nguyentrongtri-05/balance-robot/luu_do_dieu_khien_fuzzy.pdf

## LƯU ĐỒ ĐIỀU KHIỂN & TỔNG HỢP CÁC GIẢI THUẬT — BỘ LỌC XỬ LÝ TÍN HIỆU

Hệ thống Robot Hai Bánh Tự Cân Bằng trên Vi điều khiển STM32F407VG (FreeRTOS 200 Hz — Cascaded Dual-FuzzyPD & Kalman Sensor Fusion)

1. Lưu đồ Kiến trúc Hệ thống Điều khiển Vòng lồng & Đa nhiệm Thời gian thực (FreeRTOS 200 Hz)

Toàn bộ thuật toán ước lượng trạng thái, lọc nhiễu và điều khiển của robot được vận hành đồng bộ ở tần số 200 Hz (chu kỳ lấy mẫu dt = 0.005 s) trên hệ điều hành thời gian thực FreeRTOS. Công suất điều khiển tổng của cầu H ( MOTOR_PWM_PERIOD = 8400 tại tần số 10.0 kHz ) được phân bổ chặt chẽ: 90% công suất ( ±7560 PWM ) dành cho bộ điều khiển cân bằng dọc (Pitch) và 10% công suất ( ±840 PWM ) dành cho bộ điều khiển giữ hướng xoay ngang (Yaw).

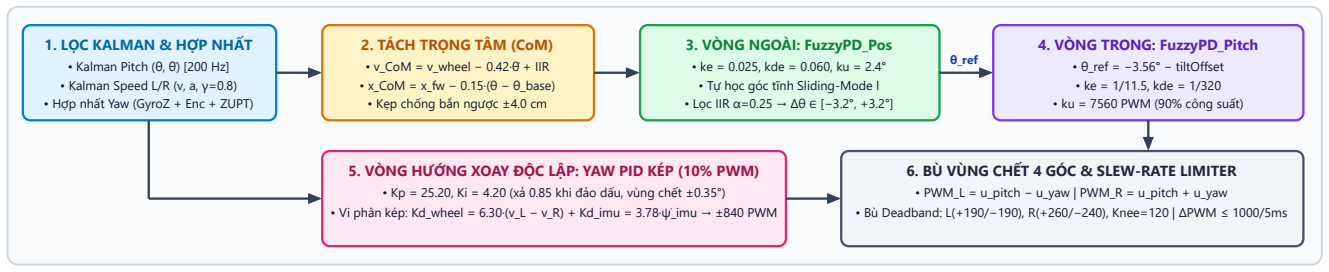
[picture p1: figure]
1. LỌC KALMAN & HỢP NHẤT • Kalman Pitch (θ, θ̇) [200 Hz] • Kalman Speed L/R (v, a, γ=0.8) • Hợp nhất Yaw (GyroZ + Enc + ZUPT); 2. TÁCH TRỌNG TÂM (CoM) • v_CoM = v_wheel − 0.42·θ̇ + IIR • x_CoM = x_fw − 0.15·(θ − θ_base) • Kẹp chống bắn ngược ±4.0 cm; 3. VÒNG NGOÀI: FuzzyPD_Pos • ke = 0.025, kde = 0.060, ku = 2.4° • Tự học góc tĩnh Sliding-Mode I • Lọc IIR α=0.25 → Δθ ∈ [−3.2°, +3.2°]; θ_ref; 4. VÒNG TRONG: FuzzyPD_Pitch • θ_ref = −3.56° − tiltOffset • ke = 1/11.5, kde = 1/320 • ku = 7560 PWM (90% công suất)

### 5. VÒNG HƯỚNG XOAY ĐỘC LẬP: YAW PID KÉP (10% PWM)

- Kp = 25.20, Ki = 4.20 (xả 0.85 khi đảo dấu, vùng chết ±0.35°)
- Vi phân kép: Kd_wheel = 6.30·(v_L − v_R) + Kd_imu = 3.78·ψ̇_imu → ±840 PWM

### 6. BÙ VÙNG CHẾT 4 GÓC & SLEW-RATE LIMITER

- PWM_L = u_pitch − u_yaw | PWM_R = u_pitch + u_yaw
- Bù Deadband: L(+190/−190), R(+260/−240), Knee=120 | ΔPWM ≤ 1000/5ms
Tên Task | Chu kỳ / Tần số | Ưu tiên | Stack (Words) | Nhiệm vụ & Giải thuật Thực thi Chính ( MY_LIB/managetask.c )
vTaskControl | 5 ms (200 Hz) | 4 (Cao nhất) | 1024 | Tách vận tốc/vị trí CoM, thực thi vòng ngoài FuzzyPD_Pos , tự học góc cân bằng tĩnh, vòng trong FuzzyPD_Pitch , bộ điều khiển Yaw PID , bù vùng chết động cơ và giới hạn Slew-Rate.
vTaskIMU | 5 ms (200 Hz) | 3 | 512 | Đọc 6 trục MPU6050 qua I2C1, tính góc g_rawAccPitch , tự hiệu chuẩn điểm 0 Gyro Z (ZUPT), hợp nhất vận tốc góc Yaw (Gyro Z + Encoder) và chạy 2 bộ lọc kalmanPitch , kalmanYaw .
vTaskEncoder | 5 ms (200 Hz) | 3 | 512 | Đọc xung vuông pha 4x từ TIM3 / TIM4 , lọc cắt gai phần cứng, tính vận tốc thô 2 bánh, chạy 2 bộ lọc kalmanSpeed_L / R và tích lũy quãng đường/góc xoay Odometry.
vTaskUART | 10 ms (100 Hz) | 2 | 512 | Giải mã gói lệnh điều khiển từ App GUI (Start/Stop/Calib/Joystick/Tuning) kiểm tra XOR Checksum và truyền khung Telemetry DMA ( 0xAA ... 0xFF ) ở tần số 50 Hz.

## 2. Xử lý Cảm biến Thô & Các Bộ lọc Tiền xử lý Phần cứng

2.1. Cảm biến Quán tính MPU6050 ( driver_i2c.c ,
managetask.c )
Bộ lọc thông thấp số nội (Hardware DLPF): Thanh ghi
CONFIG (0x1A) = 0x03 kích hoạt bộ lọc thông thấp phần cứng băng thông 44 Hz cho gia tốc kế và 42 Hz cho con quay hồi chuyển, triệt tiêu rung động cơ khí tần số cao từ động cơ trước khi lấy mẫu.
Thang đo (Full-Scale Range): Gia tốc kế ±2g ( 16384
LSB/g ), Gyroscope ±500 °/s ( 65.5 LSB/(°/s) ).
Tính góc nghiêng Pitch 3 trục & Bảo vệ dấu azSign :

θacc = atan2(−ax

, √(ay

2 + az

2
)) · (180 / π) | (1)

θ̇gyro = sign(az

) · (gy,raw − gy,offset

) / 65.5 | (2)

### 2.2. Encoder Vuông pha 4x & Lọc Cắt Gai ( encoder.c )

Bộ lọc số đầu vào Timer (Digital Input Capture Filter): Cấu hình TIM_EncoderMode_TI12 (đếm 4 cạnh xung A/B,
330 × 4 = 1320 xung/vòng ) kèm bộ lọc số phần cứng
IC1F = IC2F = 0x0F trên thanh ghi CCMR1 để loại bỏ nhiễu xuyên âm từ dây động cơ.
Khử tràn 16-bit & Bộ lọc Cắt Gai (Spike Rejection Filter): Với vận tốc tối đa của xe, số xung trong 5 ms luôn nhỏ hơn 45 xung. Nếu xuất hiện gai nhiễu bất thường | ΔN| > 45 xung/5ms , thuật toán giữ nguyên mẫu hợp lệ
liền trước:

Nếu |ΔNk

| > 45 ⇒ ΔNk = ΔNk−1 | (3)

vraw (RPM) = (60 · ΔNk

) / (1320 · 0.005) = 9.0909 · ΔNk

(4)

## 3. Các Bộ lọc Kalman Không gian Trạng thái (State-Space Kalman Filters)

Hệ thống sử dụng 4 bộ lọc Kalman tuyến tính 2 trạng thái chạy độc lập ở tần số 200 Hz ( MY_LIB/kalman.c ): 2 bộ lọc cho góc tư
thế ( kalmanPitch , kalmanYaw ) và 2 bộ lọc động học cho vận tốc bánh xe ( kalmanSpeed_L , kalmanSpeed_R ).

### 3.1. Bộ lọc Kalman Góc nghiêng & Độ trôi Gyro ( Kalman_t : kalmanPitch , kalmanYaw )

Gia tốc kế cho góc tuyệt đối không trôi nhưng chịu nhiễu gia tốc tịnh tiến rất lớn khi xe tăng/giảm tốc; ngược lại Gyroscope phản

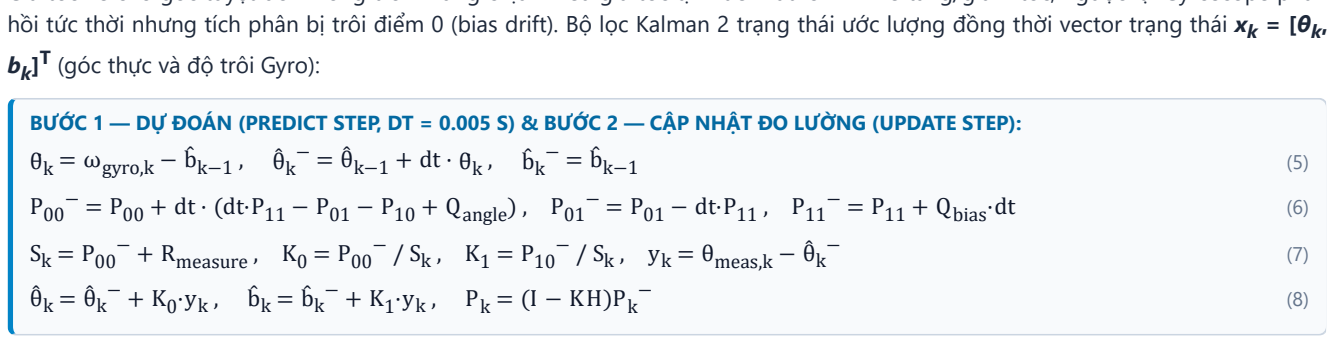
[picture p2: figure]
(góc thực và độ trôi Gyro):; θ̇k = ωgyro,k − b̂k−1; − = P11 + Qbias·dt; − + Rmeasure; , yk = θmeas,k − θ̂k

hồi tức thời nhưng tích phân bị trôi điểm 0 (bias drift). Bộ lọc Kalman 2 trạng thái ước lượng đồng thời vector trạng thái xk = [θk

BƯỚC 1 — DỰ ĐOÁN (PREDICT STEP, DT = 0.005 S) & BƯỚC 2 — CẬP NHẬT ĐO LƯỜNG (UPDATE STEP):

− = P00 + dt · (dt·P11 − P01 − P10 + Qangle

### 3.2. Bộ lọc Kalman Động học Vận tốc Bánh xe có Tắt dần Gia tốc ( KalmanSpeed_t )

Ở tần số lấy mẫu 200 Hz ( dt = 5 ms ), độ phân giải rời rạc của 1 xung Encoder tương ứng với bước nhảy bậc thang 9.09 RPM ( ≈ 3.09 cm/s ). Nếu dùng bộ lọc thông thấp RC thông thường để làm mượt bậc thang này sẽ gây trễ pha lớn ( > 50 ms ) làm xe dao động. Bộ lọc KalmanSpeed_t mô hình hóa vector trạng thái xk = [vk

, ak

]

T
(vận tốc RPM và gia tốc góc RPM/s) kết hợp hệ số tắt dần gia tốc γ = 0.80 giúp triệt tiêu hiện tượng vọt lố (overshoot) khi bánh xe đổi chiều đột ngột:

DỰ ĐOÁN ĐỘNG HỌC CÓ TẮT DẦN GIA TỐC (Γ = 0.80) & CẬP NHẬT VẬN TỐC ENCODER:

âk

− = 0.80 · âk−1
, | v̂k

− = v̂k−1 + âk

− · dt | (9)

P00

− = P00 + dt·(2P01 + dt·P11
) + Qspeed

, P01

− = P01 + dt·P11
, P11

− = P11 + Qaccel
·dt | (10)

K0 = P00

− / (P00

− + Rmeasure
) , K1 = P01

− / (P00

− + Rmeasure
) , v̂k = v̂k

− + K0
(vraw,k − v̂k

−) , âk = âk

− + K1
(vraw,k

− v̂k

−)

(11)

Bộ lọc Kalman | Biến trạng thái ước lượng | Nhiễu quá trình Q1 | Nhiễu quá trình Q2 | Nhiễu đo lường R | Đặc tính Đáp ứng Tần số / Ý nghĩa Vật lý
kalmanPitch , kalmanYaw | [angle (°), bias (°/s)] | Q_angle = 0.001 | Q_bias = 0.003 | R_measure = 0.03 | Khử hoàn toàn nhiễu rung gia tốc kế, tự động bám độ trôi nhiệt Gyro, không gây trễ pha vận tốc góc rate .
kalmanSpeed_L , kalmanSpeed_R | [speed (RPM), accel (RPM/s)] | Q_speed = 0.40 | Q_accel = 50.0 | R_measure = 5.0 | Làm phẳng hoàn toàn bậc thang lượng tử hóa 9.09 RPM/xung với độ trễ pha cực thấp ( < 20 ms ).

## 4. Giải thuật Hợp nhất Cảm biến Hướng xoay Yaw (Rate-Domain Fusion & ZUPT)

Khác với góc Pitch có trọng lực làm tham chiếu tuyệt đối, góc hướng xoay ngang Yaw (ψ) không có từ kế nên dễ bị trôi theo thời gian nếu chỉ tích phân Gyro Z, hoặc bị sai lệch nếu bánh xe bị trượt khi chỉ dùng Encoder. Đặc biệt, nếu trộn trực tiếp góc Encoder vào góc Gyro sẽ gây lỗi vật lý: khi thân xe bị xoay bởi ngoại lực rồi dừng lại ở hướng mới, hai bánh xe đứng yên làm góc Encoder cố định và kéo ngược góc Yaw về vị trí cũ. Để giải quyết triệt để, hệ thống thực hiện Hợp nhất trên miền Vận tốc góc (Rate-Domain Sensor Fusion) kết hợp Cập nhật Vận tốc Góc Bằng Không (ZUPT — Zero Angular Velocity Update) trong vTaskIMU :

### 4.1. TỰ ĐỘNG BÙ TRÔI ĐIỂM 0 TĨNH CỦA GYRO Z (ONLINE ZUPT BIAS CALIBRATION):

Nếu |ψ̇enc

| < 1.0 °/s và |gz,raw − gz,offset

| < 80 LSB ⇒ gz,offset

[k] = 0.995 · gz,offset

| [k−1] + 0.005 · gz,raw[k] | (12)

### 4.2. LUẬT HỢP NHẤT VẬN TỐC GÓC YAW BA CHẾ ĐỘ (3-REGIME RATE FUSION):

ψ̇enc = ((−v̂L − (−v̂R

)) · 0.34034) · (180 / (π · 19.21)) [°/s] | (13)
ψ̇fused = 0.0 °/s (khi |ψ̇gyro

| < 0.7 °/s và |ψ̇enc

| < 1.2 °/s — Khóa tĩnh ZUPT chống trôi tuyệt đối) = 0.80 · ψ̇gyro + 0.20 · ψ̇enc

(khi |ψ̇enc

| ≥ 1.0 °/s, ψ̇gyro

| ·ψ̇enc > 0 và |ψ̇gyro − ψ̇enc | < 20 °/s — Lăn đồng bộ)
= 1.00 · ψ̇gyro

(các trường hợp còn lại — Tác động ngoại lực xoay thân xe / trượt bánh / nhấc bổng)

(14)

ψraw[k] = ψraw[k−1] + ψ̇fused

- 0.005 , ψfiltered

[k] = Kalman_GetAngle (& kalmanYaw , ψraw[k], ψ̇gyro

, 0.005) | (15)

## 5. Khử Nhiễu Giao thoa Trọng tâm (CoM Decoupling) & Các Bộ lọc Vòng Ngoài

Đối với con lắc ngược hai bánh, khi thân xe nghiêng nhanh với vận tốc góc θ̇ để tự cân bằng, hai bánh xe phải quay cùng chiều nghiêng. Nếu đưa trực tiếp vận tốc và vị trí bánh xe vào vòng ngoài, bộ điều khiển vị trí sẽ hiểu nhầm xe đang trôi đi và ra lệnh nghiêng ngược lại, gây dao động cộng hưởng (Non-Minimum Phase coupling). Hệ thống giải quyết bằng chuỗi 5 bộ lọc tách chuyển động Trọng tâm (Center-of-Mass — CoM):

5.1. TÁCH VẬN TỐC TỊNH TIẾN TRỌNG TÂM (COM VELOCITY DECOUPLING) & LỌC THÔNG THẤP IIR BẬC 1:
vCoM,raw = vwheel − kω · clamp(θ̇kalman, −60 °/s, +60 °/s) , | với kω = 0.42 RPM/(°/s) | (16)
v̂CoM[k] = v̂CoM[k−1] + αv
- (vCoM,raw[k] − v̂CoM[k−1]) , | với αv = 0.22 (tần số cắt fc ≈ 8.0 Hz) | (17)

### 5.2. TÁCH VỊ TRÍ TRỌNG TÂM (COM POSITION DECOUPLING):

xfw = 0.5 · (NL + NR − Nref

) · 0.01547 cm , | xCoM = xfw − kθ
| · (θfiltered − θbase
| ) với kθ = 0.15 cm/° | (18)

### 5.3. BỘ KẸP CHỐNG BẮN NGƯỢC VỊ TRÍ (ANTI-SLINGSHOT POSITION CLAMPING & BRAKE-IN-PLACE):

Khi đang lái (|vcmd

| > 0.1 RPM): xtarget ← clamp(xtarget + vcmd,cms

| ·dt, xfw − 12.0 cm , xfw + 12.0 cm ) | (19)
Khi vừa nhả tay lái: chốt tức thời xtarget = xCoM (phanh đứng tại chỗ, không giật lùi về gốc cũ) | (20)

Khi đứng yên bị đẩy: xtarget ← clamp(xtarget

, xfw − 4.0 cm , xfw + 4.0 cm ) ( POS_HOLD_MAX_ERR_CM = 4.0 ) | (21)
5.4. TỰ ĐỘNG HỌC GÓC CÂN BẰNG TĨNH THEO MẶT TRƯỢT (SLIDING-MODE STATIC BALANCE AUTO-TRIM):
Mặt trượt: spos = epos + 1.2 · vCoM,cms

(trong đó epos = xfw − xtarget

| ) | (22)
Nếu epos
- spos > 0: θI,pos

[k] = clamp(θI,pos

[k−1] − 0.004 · clamp(spos

| , −4, +4) · dt, − 1.20° , + 1.20° ) | (23)

### 5.5. LỌC THÔNG THẤP GÓC NGHIÊNG ĐẶT VÒNG NGOÀI (OUTER-LOOP TILT COMMAND IIR FILTER):

Δθfilt

[k] = Δθfilt

[k−1] + 0.25 · (Δθfuzzy

[k] − Δθfilt

[k−1]) , Δθtotal = clamp(θI,pos + Δθfilt

| , − 3.2° , + 3.2° ) | (24)

Ý nghĩa Vật lý của Bộ kẹp Chống Bắn Ngược (Phương trình 21): Khi người dùng tác động lực đẩy mạnh làm xe lăn đi 15–30 cm để lấy lại thăng bằng, nếu giữ nguyên xtarget = 0 thì sai số vị trí epos tích lũy rất lớn sẽ ép vòng ngoài nghiêng xe mạnh về phía sau (hiệu ứng dây ná slingshot) ngay lúc xe vừa phanh lại, làm xe ngã ngửa. Kẹp POS_HOLD_MAX_ERR_CM = 4.0 cm cho phép điểm đích trượt theo chân xe khi bị đẩy xa, giúp vòng ngoài tập trung hãm vận tốc vCoM về 0 tại vị trí mới rồi nhẹ nhàng giữ xe đứng vững trong phạm vi ±4 cm.

## 6. Giải thuật Điều khiển Mờ Kép Nối tiếp (Cascaded Dual-FuzzyPD)

Cả hai bộ điều khiển vòng ngoài ( FuzzyPD_Pos ) và vòng trong ( FuzzyPD_Pitch ) đều dùng chung kiến trúc hàm FuzzyPD_Compute() trong MY_LIB/fuzzy.c gồm 5 khâu xử lý chuẩn hóa trên miền [-1.0, +1.0]:

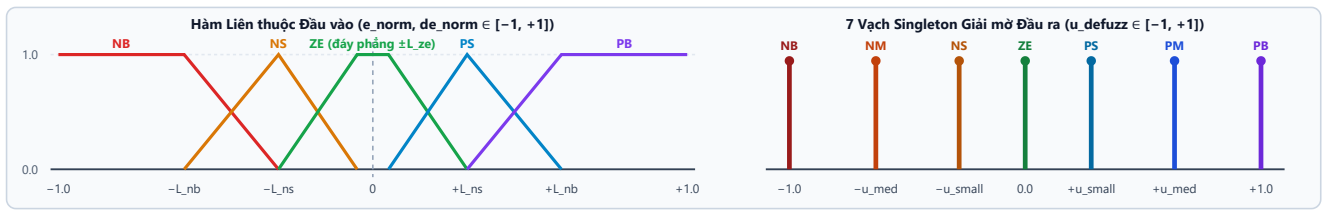
[picture p3: figure]
ZE (đáy phẳng ±L_ze); −u_med; −u_small; +u_small; +u_med

Hàm Liên thuộc Đầu vào (e_norm, de_norm ∈ [−1, +1])

### 7 Vạch Singleton Giải mờ Đầu ra (u_defuzz ∈ [−1, +1])

CHUẨN HÓA ĐẦU VÀO, SUY DIỄN TÍCH ĐẠI SỐ LARSEN (25 LUẬT) & GIẢI MỜ TRUNG BÌNH TRỌNG SỐ 7 SINGLETON:

### 6.1. Ma trận Luật Mờ Đối xứng Chuẩn 5×5 (25 Luật)

e \ de | NB | NS | ZE | PS | PB
NB | NB | NB | NM | NS | ZE
NS | NB | NM | NS | ZE | PS
ZE | NM | NS | ZE | PS | PM
PS | NS | ZE | PS | PM | PB
PB | ZE | PS | PM | PB | PB

### 6.2. Thông số Tinh chỉnh Thực tế ( MDK_ARM/main.c )

Tham số Cấu
hình

FuzzyPD_Pitch
(Vòng Trong)

FuzzyPD_Pos
(Vòng Ngoài)
Hệ số chuẩn hóa ke | 1 / 11.5 ≈ 0.08696 (±11.5°) | 0.025 (±40.0 cm)
Hệ số chuẩn hóa kde | 1 / 320 = 0.003125 (±320 °/s) | 0.060 (±16.7 cm/s)

Khuếch đại ngõ
ra ku

7560.0 PWM (90%
Full)

2.40° (Góc
nghiêng đặt)
Mốc mờ hóa e (NB, NS, ZE) | (0.46, 0.20, 0.002) | (0.44, 0.16, 0.002)
Mốc mờ hóa de (NB, NS, ZE) | (0.46, 0.20, 0.005) | (0.46, 0.18, 0.010)
Singleton (u_small, u_med) | (0.25, 0.65) | (0.26, 0.62)
Độ lợi tuyến tính tương đương | Kp ≈ 822 PWM/°, Kd ≈ 29.5 PWM/(°/s) | Kp ≈ 0.098 °/cm, Kd ≈ 0.208 °/(cm/s)

## 7. Điều khiển Hướng xoay Yaw PID Kép & Xử lý Công suất Động cơ

7.1. BỘ ĐIỀU KHIỂN YAW PID KÉP VI PHÂN (DUAL-DERIVATIVE YAW PID — 10% CÔNG SUẤT = ±840 PWM):

uyaw = clamp( Kp,yaw·eyaw + Ki,yaw·Iyaw + Kd,wheel

·(−v̂L + v̂R

) + Kd,imu

·ψ̇kalman , −840, +840 ) | (26)
- Thông số: Kp_yaw = 25.20 , Ki_yaw = 4.20 , Kd_wheel = 6.30 , Kd_imu = 3.78 . Chống bão hòa tích phân (Anti-Windup): vùng chết tích phân |e_yaw| > 0.35° , kẹp ±25.0 , và xả nhanh I_yaw *= 0.85 mỗi chu kỳ khi e_yaw đảo dấu để triệt tiêu vọt lố hướng xoay.
7.2. BÙ VÙNG CHẾT BẤT ĐỐI XỨNG 4 GÓC PHẦN TƯ CÓ ĐỘ DỐC CHUYỂN TIẾP (4-QUADRANT SOFT-KNEE DEADBAND):
uraw,L = upitch − uyaw , | uraw,R = upitch + uyaw , | DB(u) = DBpos

(nếu u > 0) hoặc DBneg

(nếu u < 0) | (27)
ucomp = u + sign(u) · DB(u) · min(1.0, |u| / Uknee
) với Uknee = 120.0 PWM | (28)
- Thông số thực đo từ công cụ Dò vùng chết ( DeadzoneDialog ): Bánh Trái DB_L_POS = 190 , DB_L_NEG = 190 ; Bánh Phải DB_R_POS = 260 , DB_R_NEG = 240 . Đoạn dốc tuyến tính U_knee = 120 PWM giúp xung PWM đi qua điểm 0 êm ái, không bị giật cục khi đảo chiều.

### 7.3. GIỚI HẠN TỐC ĐỘ BIẾN THIÊN XUNG (PWM SLEW-RATE LIMITER):

PWML/R

[k] = clamp( ucomp,L/R

[k], PWML/R

[k−1] − 1000 , PWML/R

[k−1] + 1000 ) ∈ [−8400, +8400] | (29)

## 8. Tổng kết Chất lượng Thực nghiệm trên Robot Thực tế (Dữ liệu lan39.csv )

Chỉ tiêu Đánh giá Thực nghiệm (8.063 mẫu — 403 giây vận hành liên tục) | Giá trị Đo thực tế | Đánh giá Kỹ thuật
Góc cân bằng chuẩn ( g_targetAngle ) & Độ lệch tĩnh trung bình khi đứng yên | -3.56° (lệch tĩnh < 0.05° ) | Tự động cân tâm chính xác nhờ tích phân mặt trượt s_posIntegralTilt .
Độ lệch chuẩn góc nghiêng Pitch khi đứng cân bằng tĩnh (Pitch RMS Jitter) | σ_pitch = 0.11° (p-p 0.51° ) | Đứng êm, không rung gằn nhờ vùng phẳng ZE_flat và lọc Kalman 200 Hz.
Độ lệch chuẩn vận tốc & Sai số giữ vị trí khi đứng yên (Stationary Position Hold) | σ_v = 0.70 cm/s | Δx ≤ ±0.2 cm | Giữ vị trí khóa cứng trong phạm vi ±2 mm , không dao động lắc lư.
Khả năng chống chịu ngoại lực đẩy mạnh liên tiếp (Push Recovery Test) | Đỉnh vận tốc bị đẩy 78.9 cm/s | Hồi phục cân bằng 100% sau 1.2 – 1.8 s , không xảy ra hiện tượng bắn ngược (0 lần ngã).
Độ ổn định góc hướng xoay Yaw khi đứng yên (ZUPT + Rate Fusion) | Độ trôi 0.000 °/s (sai số < 0.08° ) | Khóa tĩnh tuyệt đối khi đứng yên, không bị kéo lệch khi có ngoại lực xoay thân xe.

Đồ thị Thực nghiệm Thời gian thực trên Phần cứng STM32F407VG (Dữ liệu Telemetry DMA 50 Hz — lan39.csv tại

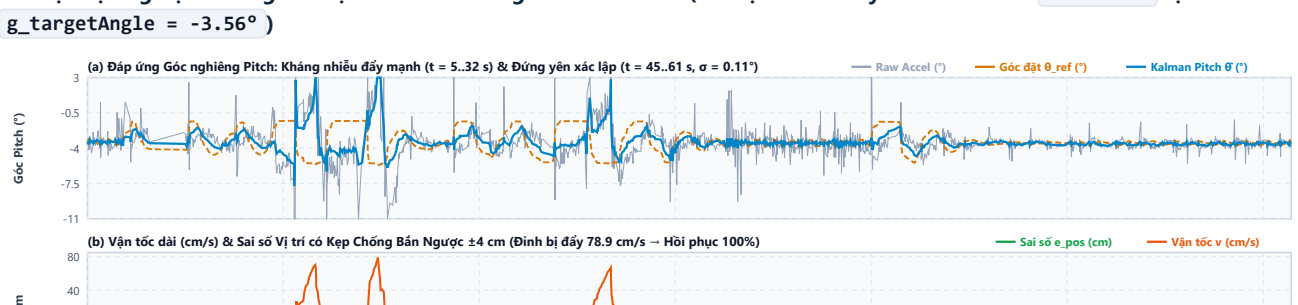
[picture p4: figure]
g_targetAngle = -3.56° ); Góc Pitch (°)

(a) Đáp ứng Góc nghiêng Pitch: Kháng nhiễu đẩy mạnh (t = 5..32 s) & Đứng yên xác lập (t = 45..61 s, σ = 0.11°) | Raw Accel (°) | Góc đặt θ_ref (°) | Kalman Pitch θ̂ (°)
(b) Vận tốc dài (cm/s) & Sai số Vị trí có Kẹp Chống Bắn Ngược ±4 cm (Đỉnh bị đẩy 78.9 cm/s → Hồi phục 100%) | Sai số e_pos (cm) | Vận tốc v (cm/s)
cm/s | cm

-80

-40

0

(c) Công suất Điều khiển Vòng trong OutFuzzy (% PWM, giới hạn ±90% = ±7560/8400) | OutFuzzy (% PWM)

OutFuzzy (%)

-100

-50

0

50

100

(d) Vận tốc góc Yaw (°/s) & Sai số Hướng xoay Yaw (°) — Hợp nhất Rate-Domain + Khóa tĩnh ZUPT (0.000 °/s khi đứng yên) | Vận tốc góc ψ̇ (°/s) | Sai số Yaw e_ψ (°)
Yaw (° | °/s)

-20

-10

0

10

20

0 s | 10 s | 20 s | 30 s | 40 s | 50 s | 60 s
Thời gian thực nghiệm liên tục Δt (giây, trích xuất từ lan39.csv: t = 196.0s → 257.5s)
