nguyentrongtri-05/balance-robot/3d/Motor Mount JGB37/MM-JGB37 v4.jpg

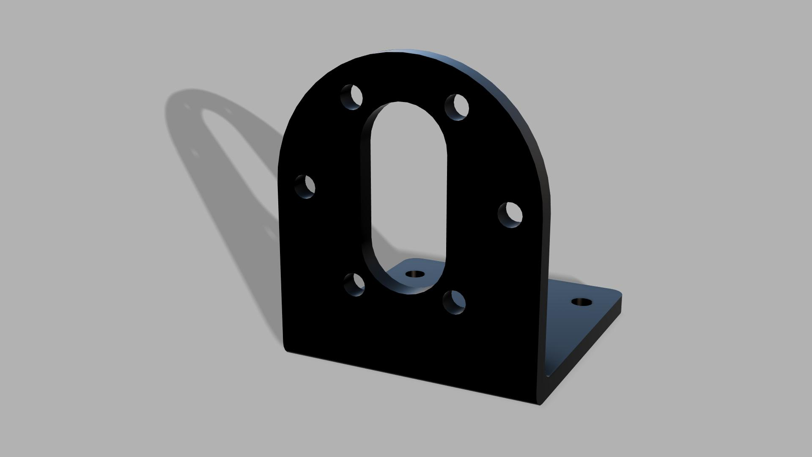
3d/Motor Mount JGB37/MM-JGB37 v4.jpg
