nguyentrongtri-05/balance-robot/3d/Motor Mount JGB37/MM-JGB37.png

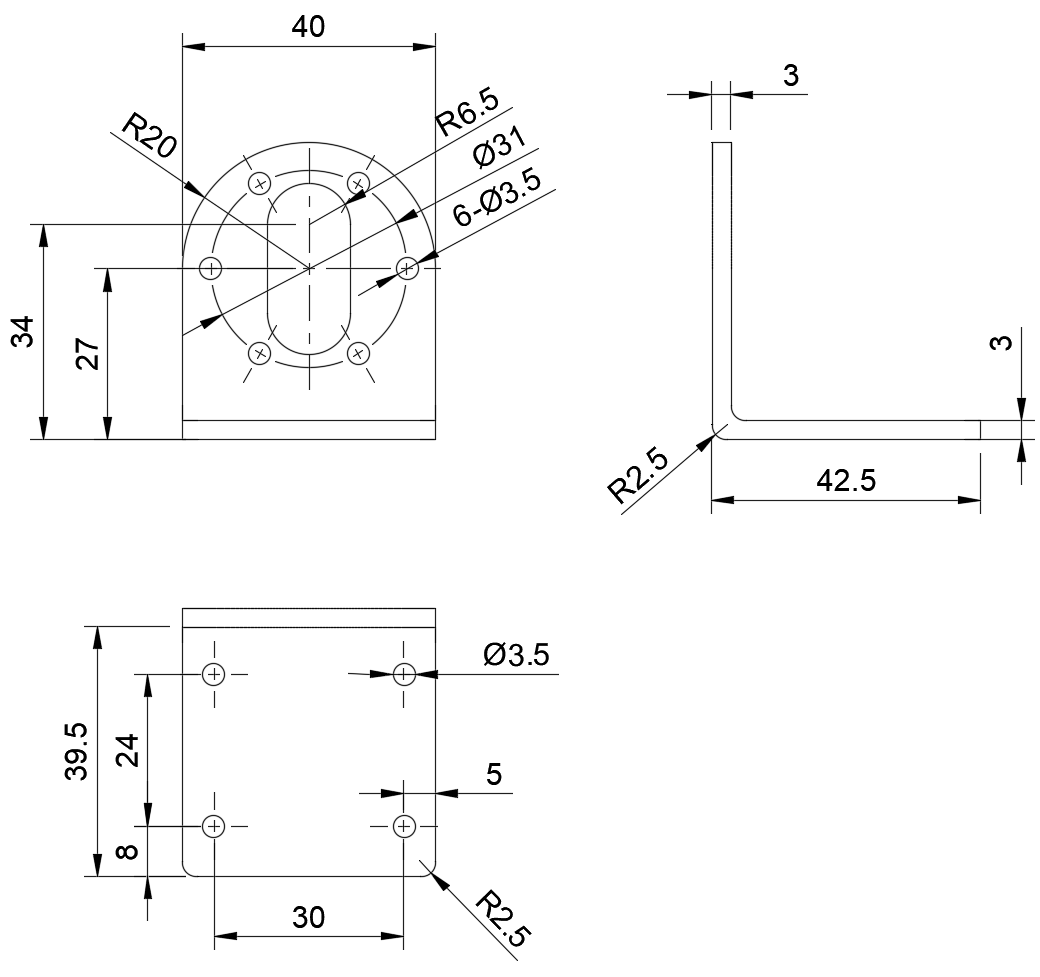
3d/Motor Mount JGB37/MM-JGB37.png
