nguyentrongtri-05/balance-robot/SIMULATE/stl/main - JGB37-520-3 MM-JGB37 v4-1.STL

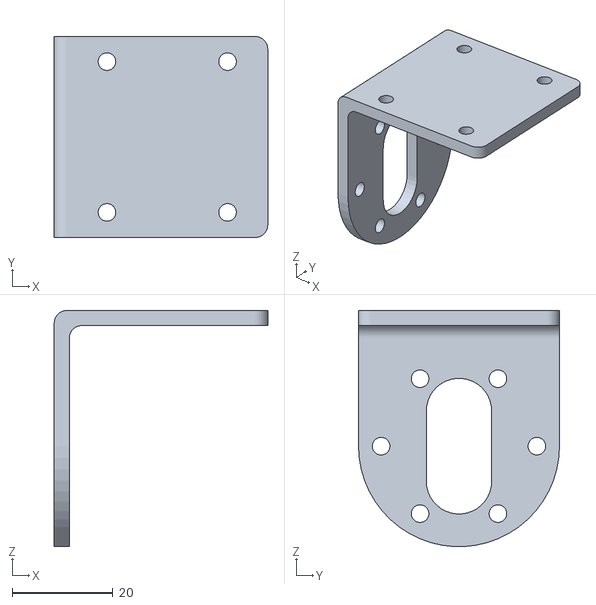
[picture p7: CAD file, 2026-11-10]
SIMULATE/stl/main - JGB37-520-3 MM-JGB37 v4-1.STL
42.5 x 40.0 x 47.0
