nguyentrongtri-05/balance-robot/SIMULATE/stl/main - 2_Vias-3.STL

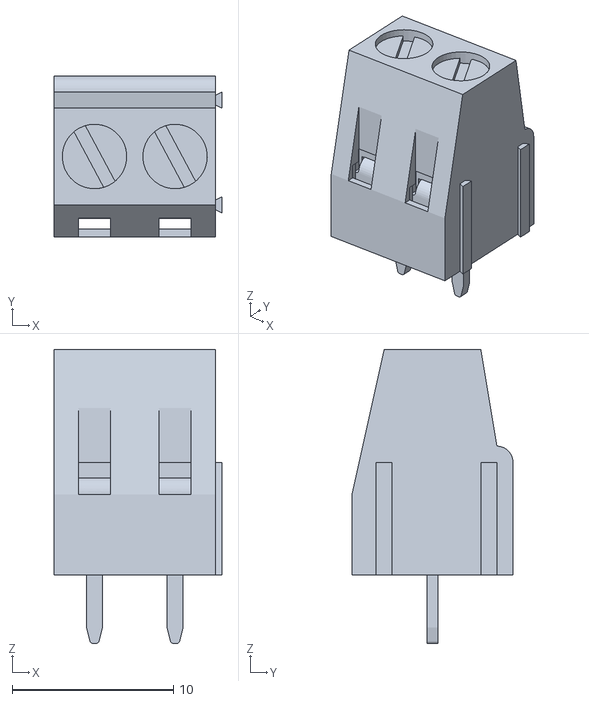
[picture p8: CAD file, 2026-11-10]
SIMULATE/stl/main - 2_Vias-3.STL
10.4 x 10.0 x 18.2
