nguyentrongtri-05/balance-robot/SIMULATE/stl/main - Chassis-2.STL

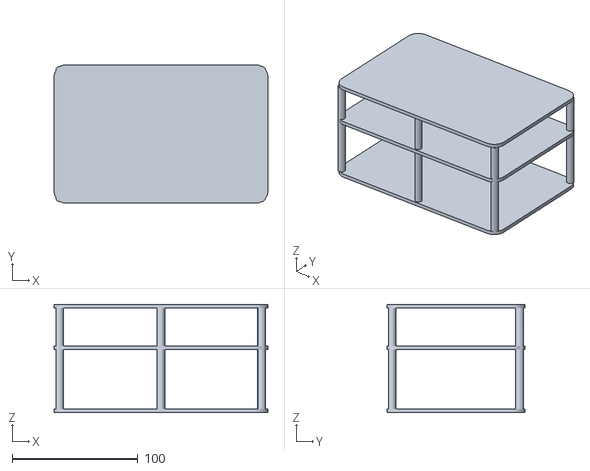
[picture p9: CAD file, 2026-11-10]
SIMULATE/stl/main - Chassis-2.STL
170.0 x 110.0 x 86.0
