nguyentrongtri-05/balance-robot/SIMULATE/stl/main - JGB37-520-3 pan cross head_am-3.STL

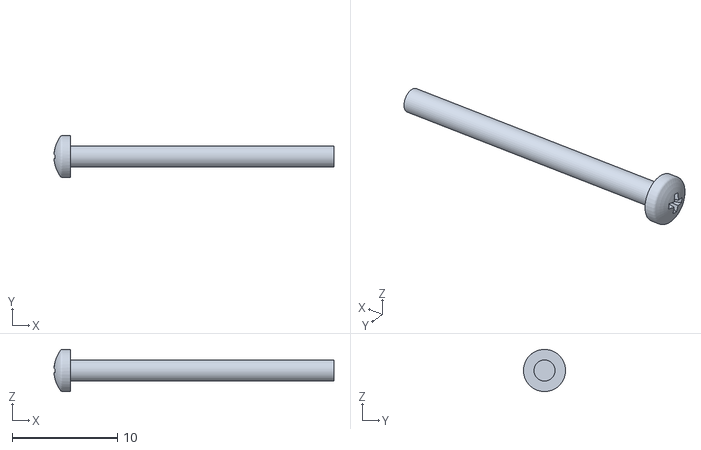
[picture p10: CAD file, 2026-11-10]
SIMULATE/stl/main - JGB37-520-3 pan cross head_am-3.STL
26.6 x 4.00 x 4.00
