nguyentrongtri-05/balance-robot/SIMULATE/stl/main - JGB37-520-3 GEARED BODY, MOTOR, JGB37-520-1.STL

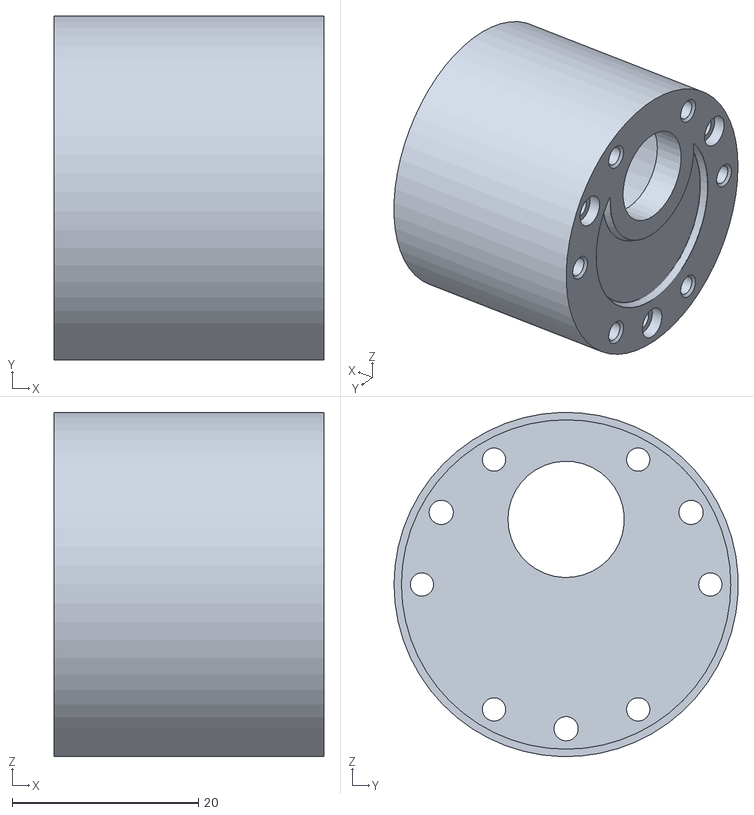
[picture p11: CAD file, 2026-11-10]
SIMULATE/stl/main - JGB37-520-3 GEARED BODY, MOTOR, JGB37-520-1.STL
29.0 x 37.0 x 37.0
