nguyentrongtri-05/balance-robot/SIMULATE/stl/main - Banh xe va khop noi-2.STL

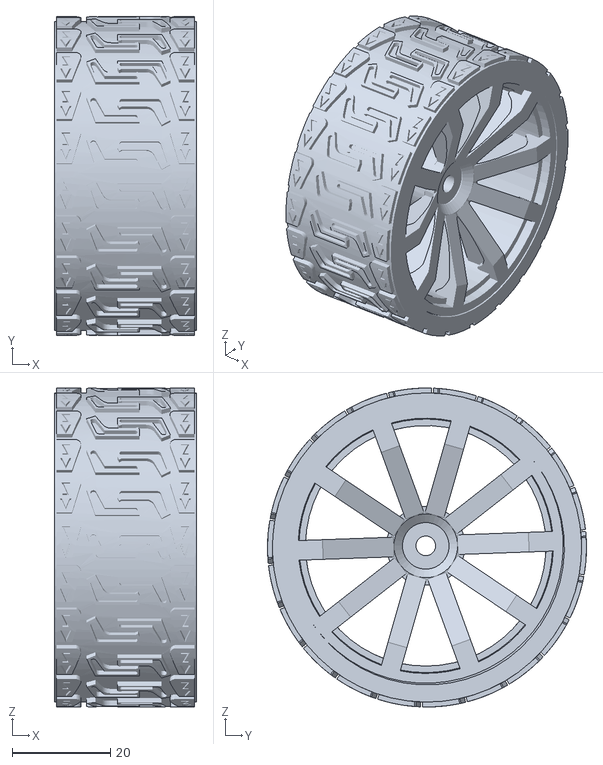
[picture p12: CAD file, 2026-11-10]
SIMULATE/stl/main - Banh xe va khop noi-2.STL
29.0 x 65.0 x 65.0
