nguyentrongtri-05/balance-robot/SIMULATE/stl/main - TATTU 1800mah 4s-1 JST XHP-4-1.STL

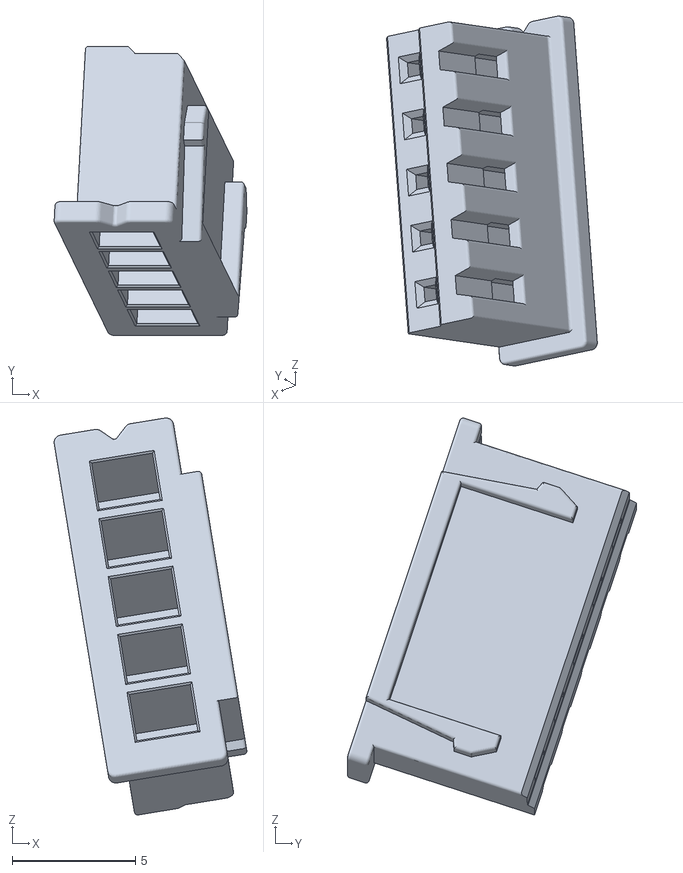
[picture p13: CAD file, 2026-11-10]
SIMULATE/stl/main - TATTU 1800mah 4s-1 JST XHP-4-1.STL
7.81 x 11.7 x 16.1
