nguyentrongtri-05/balance-robot/3d/main.SLDASM

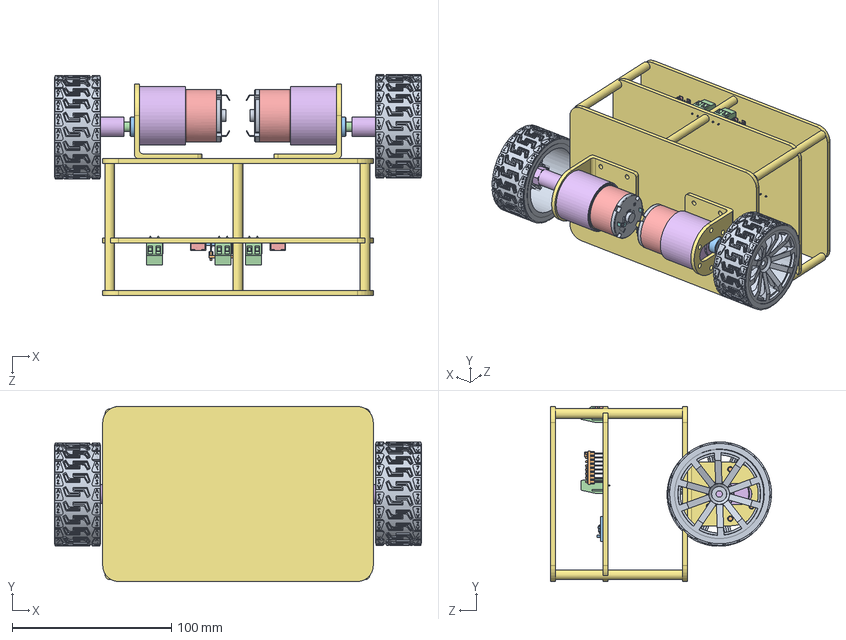
[picture p14: CAD file, 2026-11-10]
3d/main.SLDASM
230.6 x 110.0 x 138.8 mm
Chassis
GEARED BODY, MOTOR, JGB37-520 x 2
DC MOTOR, JGB37-520 x 2
MOTOR SHAFT, JGB37-520 x 2
SHAFT COUPLER, JGB37-520 x 2
COUPLING BRACKET, GEARED BODY TO DC MOTOR, JGB37-520 x 2
PLASTIC COVER, DC MOTOR, JGB37-520 x 2
CONNECTION, DC MOTOR, JGB37-520 x 4
MM-JGB37 v4 x 2
khop_noi_6mm x 2
4 PIN PCB CONNECTOR2MM x 2
2_Vias x 3
MPU6050 Accelerometer
TB6612FNG_Lower Pins
Banh xe va khop noi x 2
