nguyentrongtri-05/balance-robot/SIMULATE/stl/main - JGB37-520-4 PLASTIC COVER, DC MOTOR, JGB37-520-1.STL

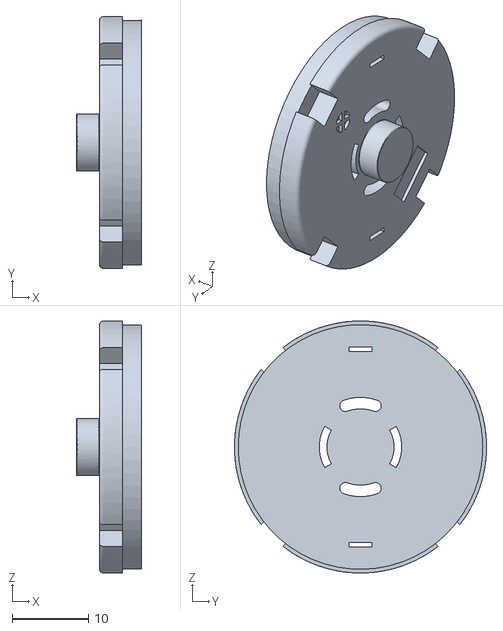
[picture p15: CAD file, 2026-11-10]
SIMULATE/stl/main - JGB37-520-4 PLASTIC COVER, DC MOTOR, JGB37-520-1.STL
8.50 x 33.0 x 33.0
