nguyentrongtri-05/balance-robot/SIMULATE/stl/main - 4 PIN PCB CONNECTOR2MM-1.STL

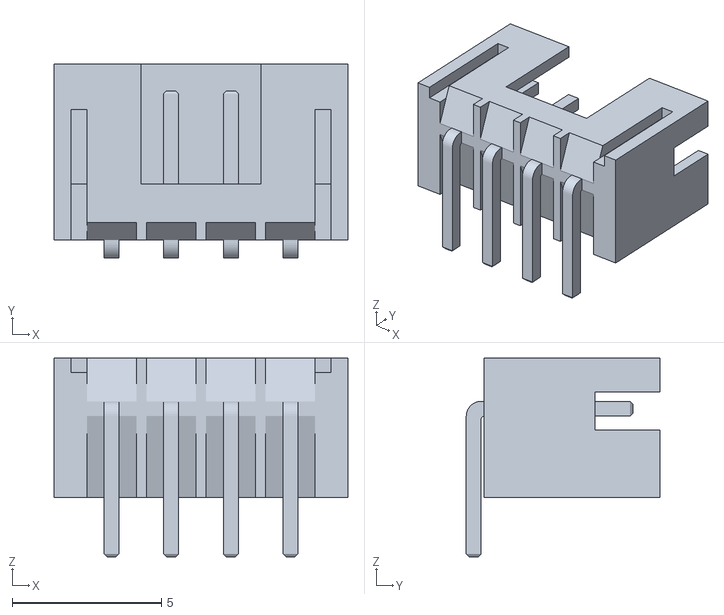
[picture p16: CAD file, 2026-11-10]
SIMULATE/stl/main - 4 PIN PCB CONNECTOR2MM-1.STL
9.86 x 6.49 x 6.67
