nguyentrongtri-05/balance-robot/3d/JGB37-520.SLDASM

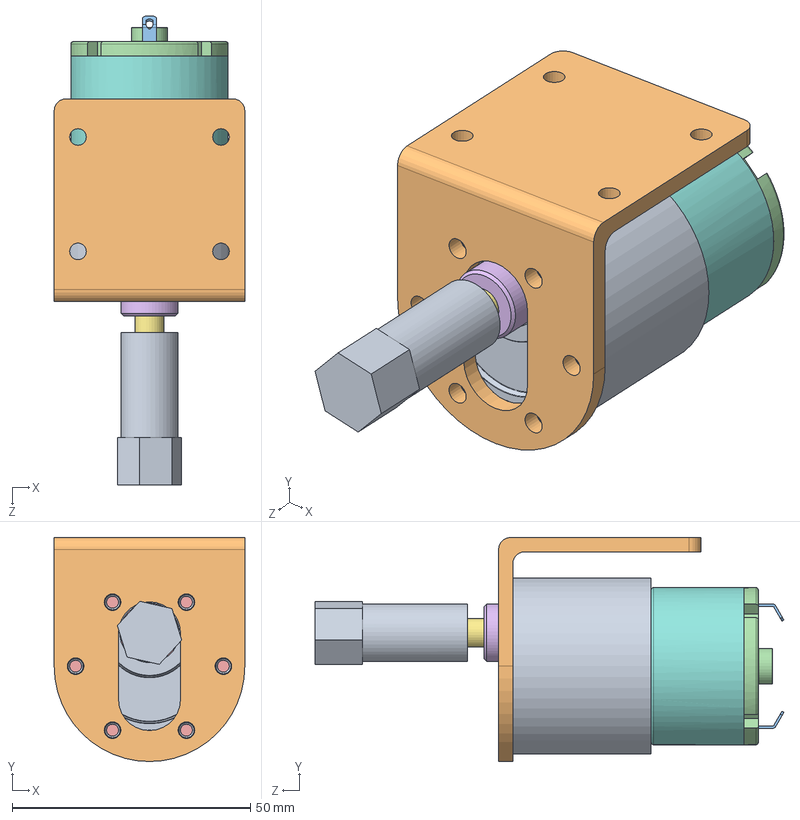
[picture p17: CAD file, 2026-11-10]
3d/JGB37-520.SLDASM
40.0 x 47.0 x 98.4 mm
GEARED BODY, MOTOR, JGB37-520
DC MOTOR, JGB37-520
MOTOR SHAFT, JGB37-520
SHAFT COUPLER, JGB37-520
COUPLING BRACKET, GEARED BODY TO DC MOTOR, JGB37-520
PLASTIC COVER, DC MOTOR, JGB37-520
CONNECTION, DC MOTOR, JGB37-520 x 2
MM-JGB37 v4
khop_noi_6mm
