nguyentrongtri-05/balance-robot/SIMULATE/stl/main - JGB37-520-3 MOTOR SHAFT, JGB37-520-1.STL

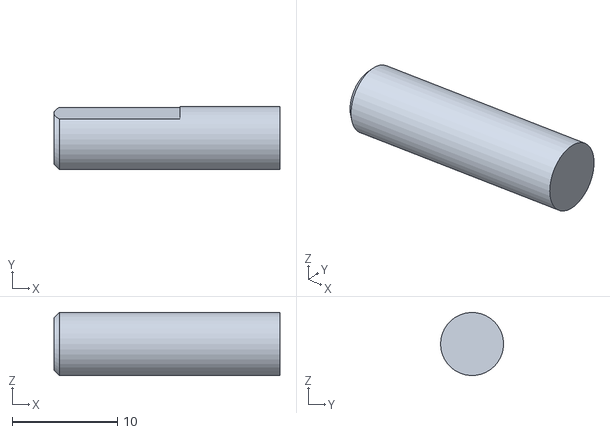
[picture p19: CAD file, 2026-11-10]
SIMULATE/stl/main - JGB37-520-3 MOTOR SHAFT, JGB37-520-1.STL
21.5 x 5.99 x 5.99
