nguyentrongtri-05/balance-robot/SIMULATE/stl/main - JGB37-520-4 khop_noi_6mm-2.STL

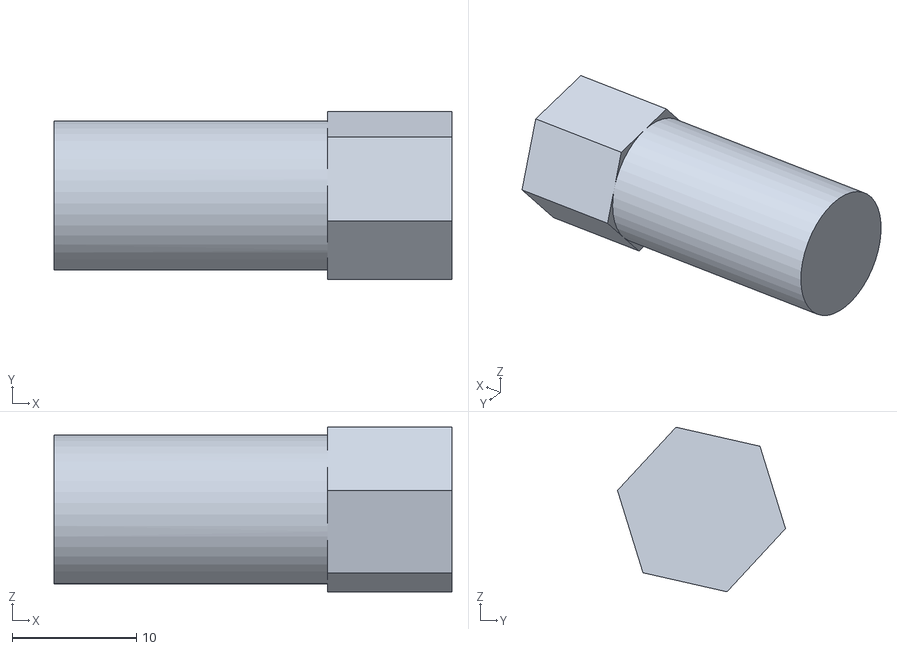
[picture p20: CAD file, 2026-11-10]
SIMULATE/stl/main - JGB37-520-4 khop_noi_6mm-2.STL
32.0 x 13.5 x 13.2
