nguyentrongtri-05/balance-robot/SIMULATE/stl/main - TATTU 1800mah 4s-1 FUNDA-1.STL

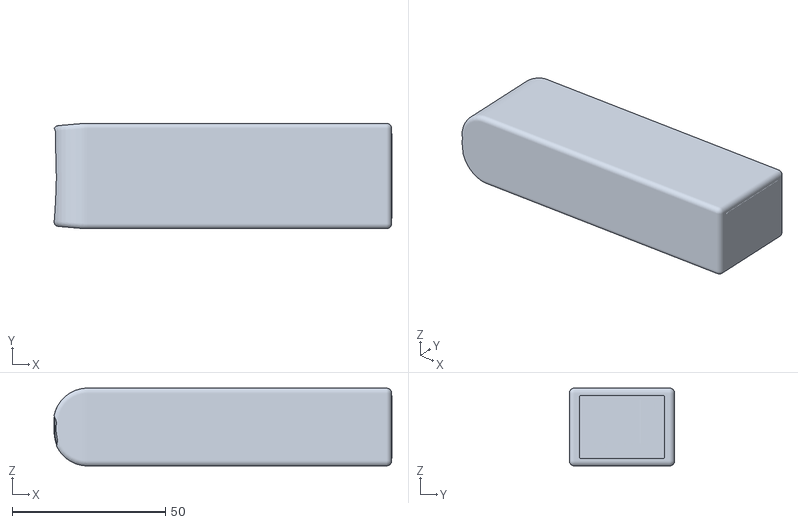
[picture p21: CAD file, 2026-11-10]
SIMULATE/stl/main - TATTU 1800mah 4s-1 FUNDA-1.STL
110.3 x 34.4 x 25.4
