nguyentrongtri-05/balance-robot/SIMULATE/stl/main - JGB37-520-3 CONNECTION, DC MOTOR, JGB37-520-1.STL

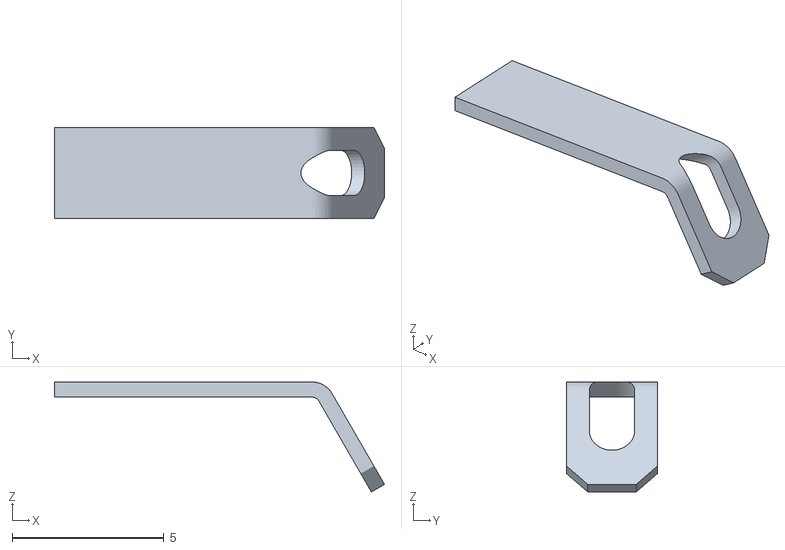
[picture p22: CAD file, 2026-11-10]
SIMULATE/stl/main - JGB37-520-3 CONNECTION, DC MOTOR, JGB37-520-1.STL
10.9 x 3.00 x 3.62
