nguyentrongtri-05/balance-robot/SIMULATE/stl/main - JGB37-520-4 SHAFT COUPLER, JGB37-520-1.STL

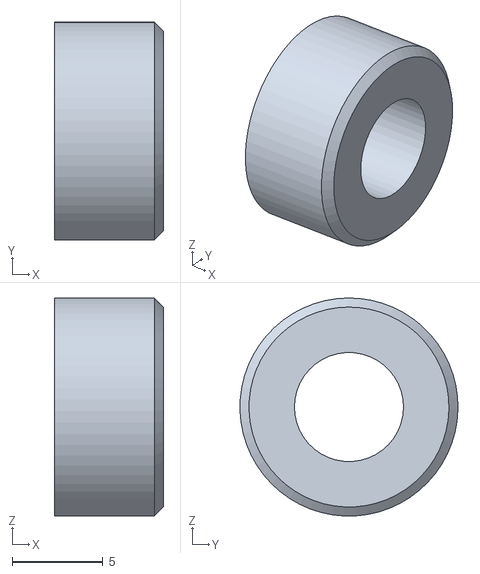
[picture p23: CAD file, 2026-11-10]
SIMULATE/stl/main - JGB37-520-4 SHAFT COUPLER, JGB37-520-1.STL
6.00 x 12.0 x 12.0
