nguyentrongtri-05/balance-robot/SIMULATE/stl/main - JGB37-520-4 COUPLING BRACKET, GEARED BODY TO DC MOTOR, JGB37-520-1.STL

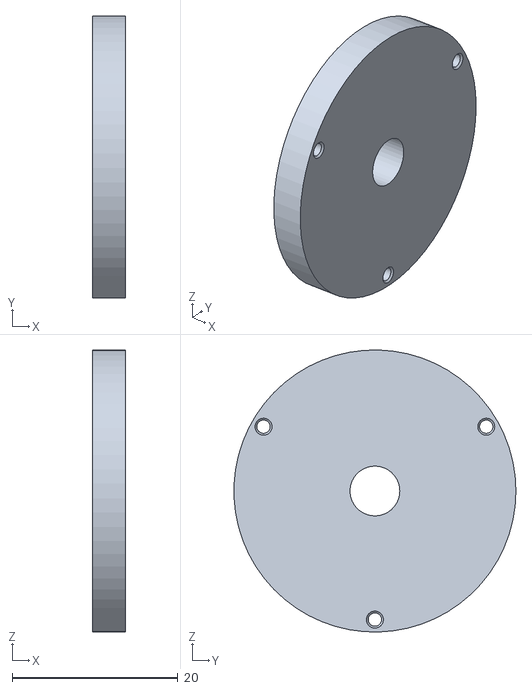
[picture p24: CAD file, 2026-11-10]
SIMULATE/stl/main - JGB37-520-4 COUPLING BRACKET, GEARED BODY TO DC MOTOR, JGB37-520-1.STL
4.00 x 34.0 x 34.0
