nguyentrongtri-05/balance-robot/SIMULATE/stl/main - TATTU 1800mah 4s-1 XT60 Buchse-2.STL

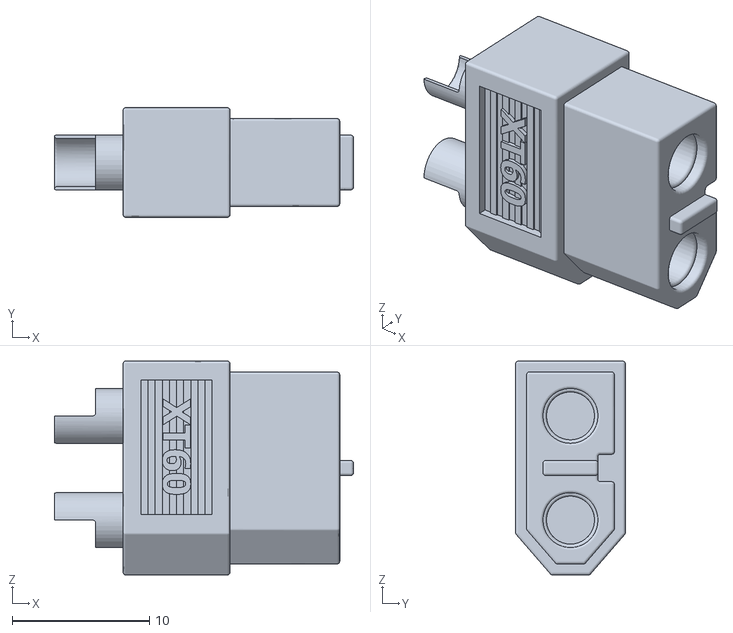
[picture p25: CAD file, 2026-11-10]
SIMULATE/stl/main - TATTU 1800mah 4s-1 XT60 Buchse-2.STL
21.8 x 8.00 x 15.6
