nguyentrongtri-05/balance-robot/SIMULATE/stl/main - TATTU 1800mah 4s-1 NUCLEO-1.STL

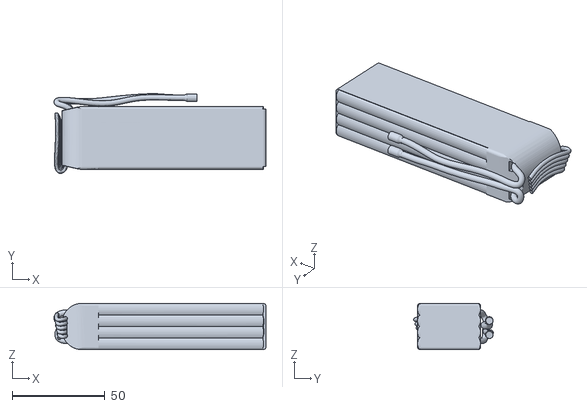
[picture p26: CAD file, 2026-11-10]
SIMULATE/stl/main - TATTU 1800mah 4s-1 NUCLEO-1.STL
114.2 x 43.0 x 25.0
