nguyentrongtri-05/balance-robot/SIMULATE/stl/main - Blue_KIT_STM32F407VG-1.STL

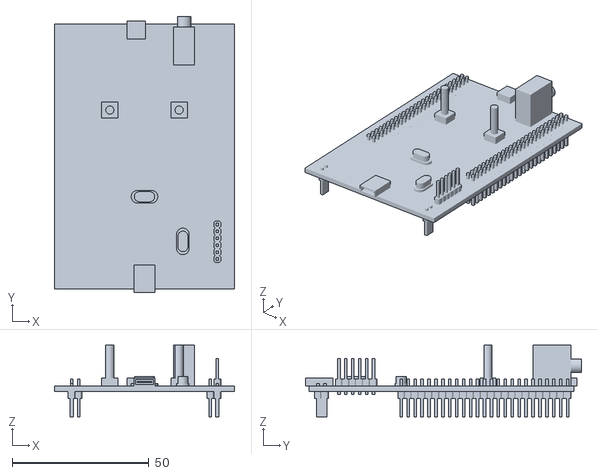
[picture p27: CAD file, 2026-11-10]
SIMULATE/stl/main - Blue_KIT_STM32F407VG-1.STL
66.0 x 101.1 x 26.3
