nguyentrongtri-05/balance-robot/SIMULATE/stl/main - JGB37-520-3 DC MOTOR, JGB37-520-1.STL

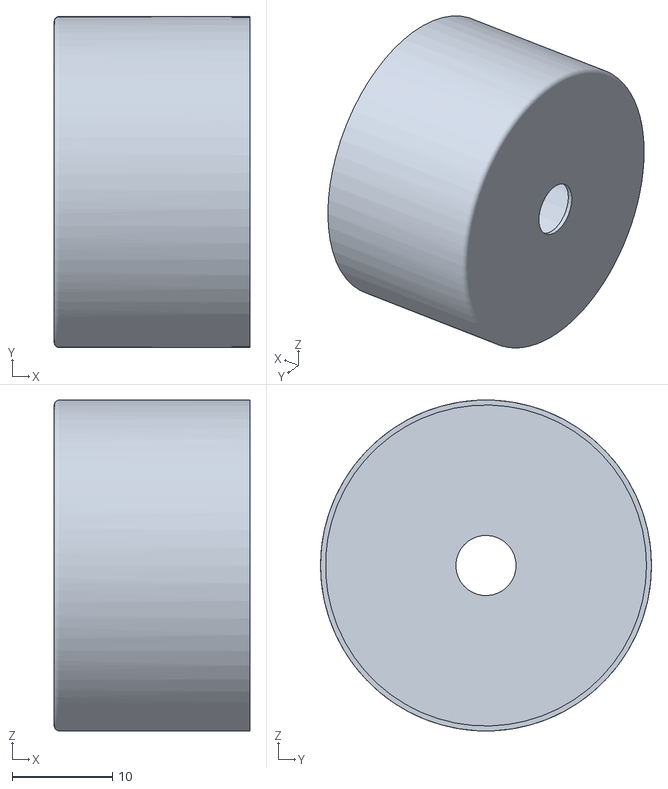
[picture p28: CAD file, 2026-11-10]
SIMULATE/stl/main - JGB37-520-3 DC MOTOR, JGB37-520-1.STL
19.5 x 33.0 x 33.0
