nguyentrongtri-05/balance-robot/SIMULATE/stl/main - TB6612FNG_Lower Pins-1.STL

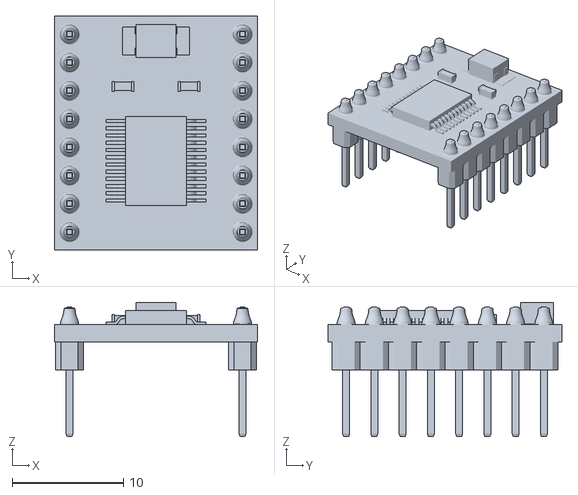
[picture p29: CAD file, 2026-11-10]
SIMULATE/stl/main - TB6612FNG_Lower Pins-1.STL
18.2 x 21.0 x 12.1
