nguyentrongtri-05/balance-robot/SIMULATE/stl/main - MPU6050 Accelerometer-1.STL

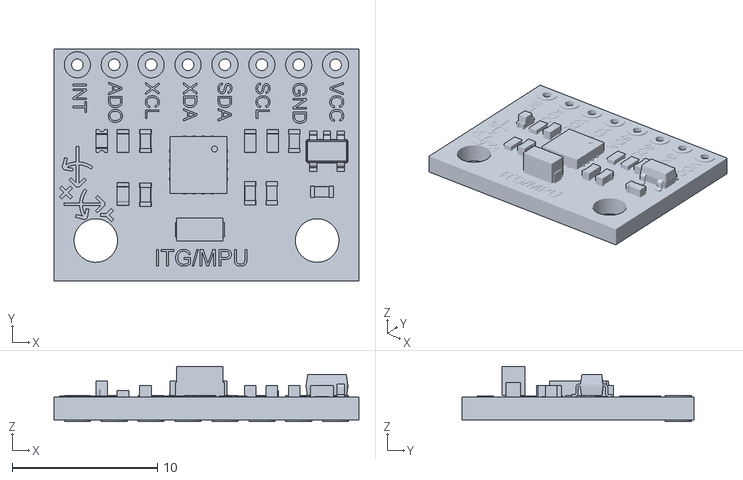
[picture p30: CAD file, 2026-11-10]
SIMULATE/stl/main - MPU6050 Accelerometer-1.STL
21.0 x 16.0 x 3.80
