nguyentrongtri-05/balance-robot/SIMULATE/khop_noi_6mm_Default_sldprt.STEP

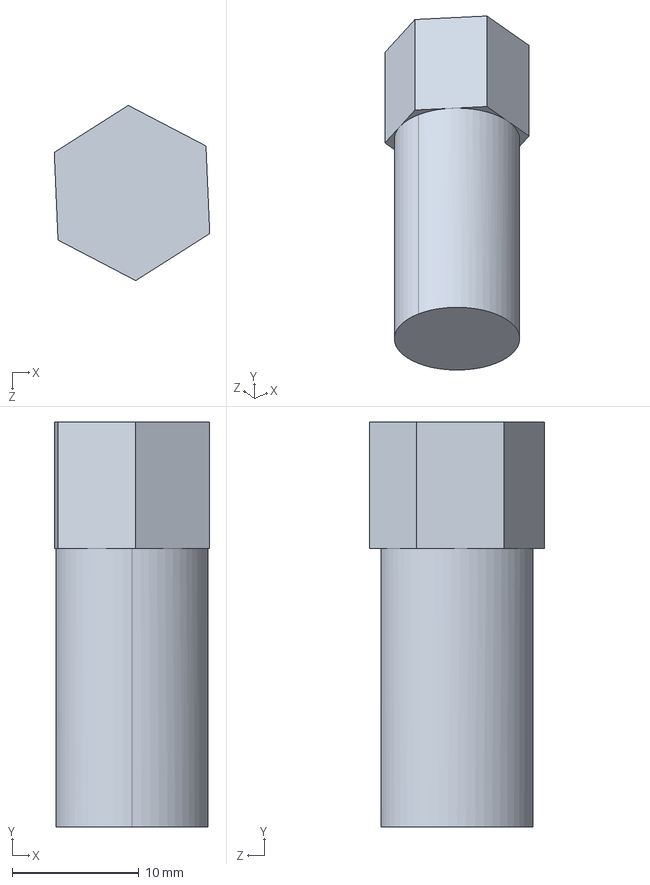
[picture p31: CAD file, 2026-11-10]
SIMULATE/khop_noi_6mm_Default_sldprt.STEP
12.3 x 32.0 x 13.8 mm
