nguyentrongtri-05/balance-robot/3d/Chassis.SLDPRT

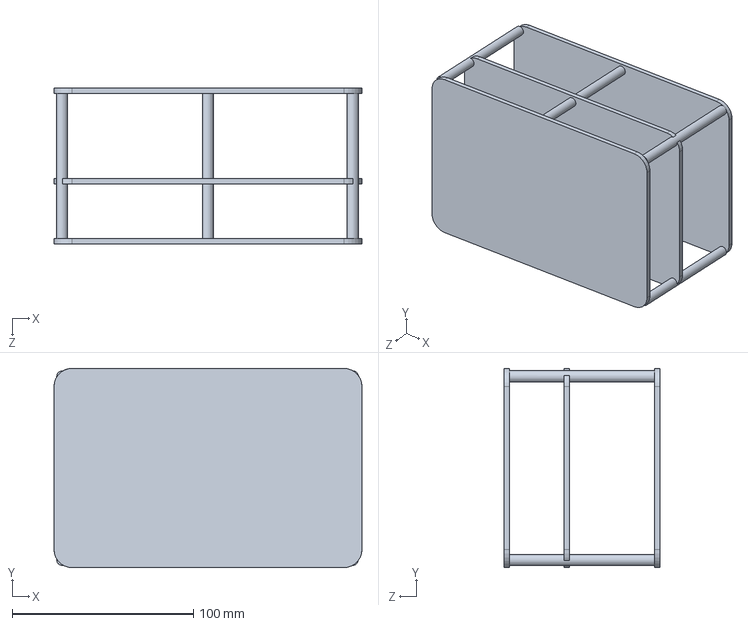
[picture p32: CAD file, 2026-11-10]
3d/Chassis.SLDPRT
170.0 x 110.0 x 86.0 mm
