nguyentrongtri-05/balance-robot/SIMULATE/JST XHP-4_Predeterminado_sldprt.STEP

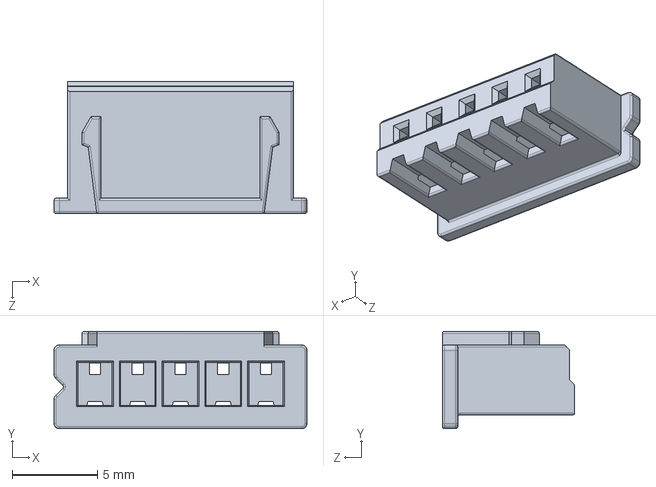
[picture p33: CAD file, 2026-11-10]
SIMULATE/JST XHP-4_Predeterminado_sldprt.STEP
14.8 x 5.70 x 7.75 mm
