nguyentrongtri-05/balance-robot/3d/TATTU 1800mah 4s.SLDPRT

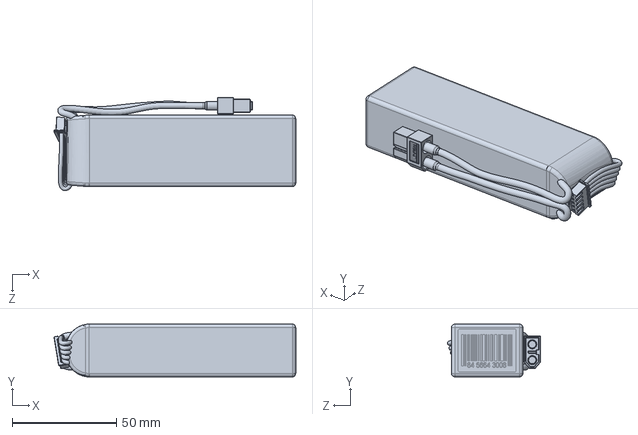
[picture p34: CAD file, 2026-11-10]
3d/TATTU 1800mah 4s.SLDPRT
116.3 x 25.4 x 44.8 mm
