nguyentrongtri-05/balance-robot/SIMULATE/Chassis_Default_sldprt.STEP

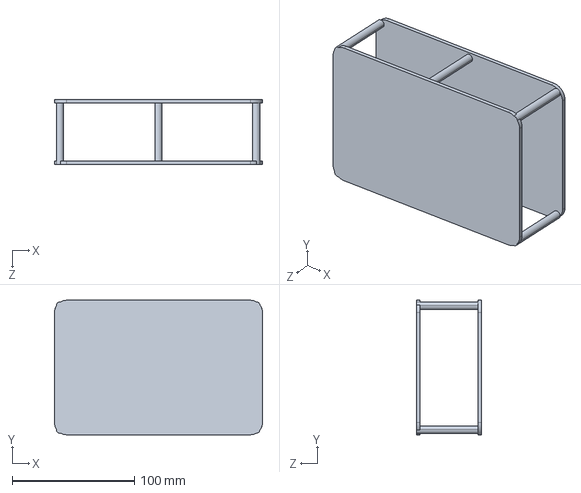
[picture p35: CAD file, 2026-11-10]
SIMULATE/Chassis_Default_sldprt.STEP
170.0 x 110.0 x 53.0 mm
