nguyentrongtri-05/balance-robot/SIMULATE/stl/thanxe.STL

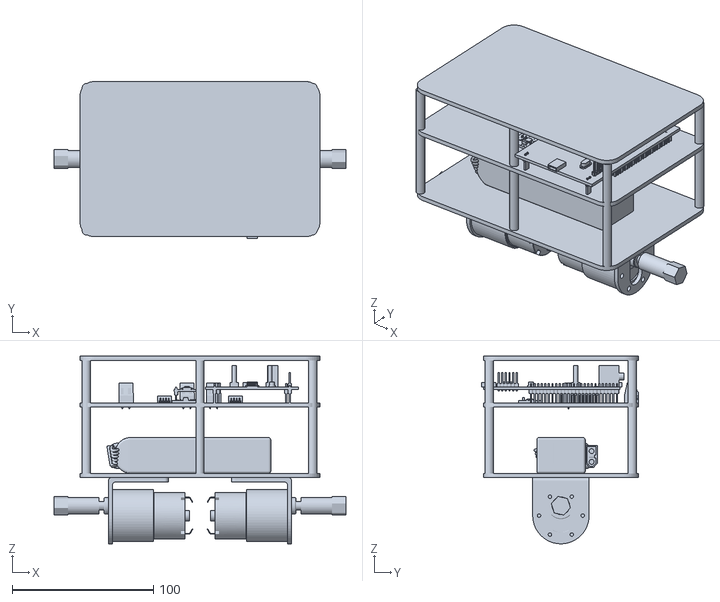
[picture p36: CAD file, 2026-11-10]
SIMULATE/stl/thanxe.STL
207.0 x 111.3 x 133.0
