nguyentrongtri-05/balance-robot/(list of files, cad)

Other CAD files:
SIMULATE/stl/main - 2_Vias-4.STL
3d/2_Vias.STEP.SLDASM
SIMULATE/stl/main - JGB37-520-4 pan cross head_am-4.STL
SIMULATE/stl/main - JGB37-520-4 pan cross head_am-3.STL
SIMULATE/stl/main - JGB37-520-3 pan cross head_am-5.STL
SIMULATE/stl/main - Banh xe va khop noi-1.STL
SIMULATE/stl/main - JGB37-520-3 SHAFT COUPLER, JGB37-520-1.STL
SIMULATE/stl/main - JGB37-520-4 MOTOR SHAFT, JGB37-520-1.STL
SIMULATE/stl/main - JGB37-520-3 khop_noi_6mm-2.STL
SIMULATE/stl/main - JGB37-520-4 pan cross head_am-5.STL
SIMULATE/stl/main - JGB37-520-3 CONNECTION, DC MOTOR, JGB37-520-2.STL
SIMULATE/stl/main - 4 PIN PCB CONNECTOR2MM-5.STL
SIMULATE/stl/main - JGB37-520-4 GEARED BODY, MOTOR, JGB37-520-1.STL
SIMULATE/stl/main - JGB37-520-4 CONNECTION, DC MOTOR, JGB37-520-1.STL
SIMULATE/stl/main - JGB37-520-4 CONNECTION, DC MOTOR, JGB37-520-2.STL
SIMULATE/stl/main - 2_Vias-2.STL
SIMULATE/stl/main - JGB37-520-3 COUPLING BRACKET, GEARED BODY TO DC MOTOR, JGB37-520-1.STL
SIMULATE/stl/main - JGB37-520-3 pan cross head_am-4.STL
SIMULATE/stl/main - JGB37-520-3 PLASTIC COVER, DC MOTOR, JGB37-520-1.STL
SIMULATE/stl/main - JGB37-520-4 DC MOTOR, JGB37-520-1.STL
3d/Banh xe va khop noi.SLDPRT
3d/jgb37-520-1.snapshot.4/SHAFT COUPLER, JGB37-520.SLDPRT
3d/Motor Mount JGB37/MM-JGB37 v4.stl
SIMULATE/4 PIN PCB CONNECTOR2MM_Default_sldprt.STEP
3d/4 PIN PCB CONNECTOR2MM.SLDPRT
3d/jgb37-520-1.snapshot.4/DC MOTOR, JGB37-520.SLDPRT
3d/Motor Mount JGB37/MM-JGB37 v3.iges
3d/jgb37-520-1.snapshot.4/MOTOR SHAFT, JGB37-520.SLDPRT
3d/MPU6050 Accelerometer.SLDPRT
SIMULATE/pan cross head_am_B18.6.7M - M2 x 0.4 x 25 Type I Cross Recessed PHMS --25N_sldprt.STEP
SIMULATE/stl/banhphai.STL
3d/jgb37-520-1.snapshot.4/CONNECTION, DC MOTOR, JGB37-520.SLDPRT
SIMULATE/MPU6050 Accelerometer_Default_sldprt.STEP
3d/jgb37-520-1.snapshot.4/GEARED BODY, MOTOR, JGB37-520.SLDPRT
3d/TB6612FNG_Lower Pins.SLDPRT
3d/2_Vias.SLDPRT
3d/jgb37-520-1.snapshot.4/COUPLING BRACKET, GEARED BODY TO DC MOTOR, JGB37-520.SLDPRT
SIMULATE/NUCLEO_Predeterminado_sldprt.STEP
3d/jgb37-520-1.snapshot.4/PLASTIC COVER, DC MOTOR, JGB37-520.SLDPRT
SIMULATE/FUNDA_Predeterminado_sldprt.STEP
3d/Blue_KIT_STM32F407VG.STEP
SIMULATE/COUPLING BRACKET- GEARED BODY TO DC MOTOR- JGB37-520_Default_sldprt.STEP
3d/khop_noi_6mm.SLDPRT
SIMULATE/PLASTIC COVER- DC MOTOR- JGB37-520_Default_sldprt.STEP
SIMULATE/MOTOR SHAFT- JGB37-520_Default_sldprt.STEP
3d/MM-JGB37 v4.SLDPRT
SIMULATE/DC MOTOR- JGB37-520_Default_sldprt.STEP
SIMULATE/MM-JGB37 v4_Default_sldprt.STEP
SIMULATE/2_Vias_Default_sldprt.STEP
SIMULATE/XT60 Buchse_Predeterminado_sldprt.STEP
SIMULATE/CONNECTION- DC MOTOR- JGB37-520_Default_sldprt.STEP
SIMULATE/GEARED BODY- MOTOR- JGB37-520_Default_sldprt.STEP
SIMULATE/Blue_KIT_STM32F407VG_Default_sldprt.STEP
SIMULATE/SHAFT COUPLER- JGB37-520_Default_sldprt.STEP
SIMULATE/Banh xe va khop noi_Default_sldprt.STEP
SIMULATE/stl/banhtrai.STL
3d/Blue_KIT_STM32F407VG.SLDPRT
3d/Motor Mount JGB37/MM-JGB37 v3.obj
3d/Motor Mount JGB37/MM-JGB37.f3d
