nguyentrongtri-05/balance-robot/Hardware/PCB_Project/boardin.pdf

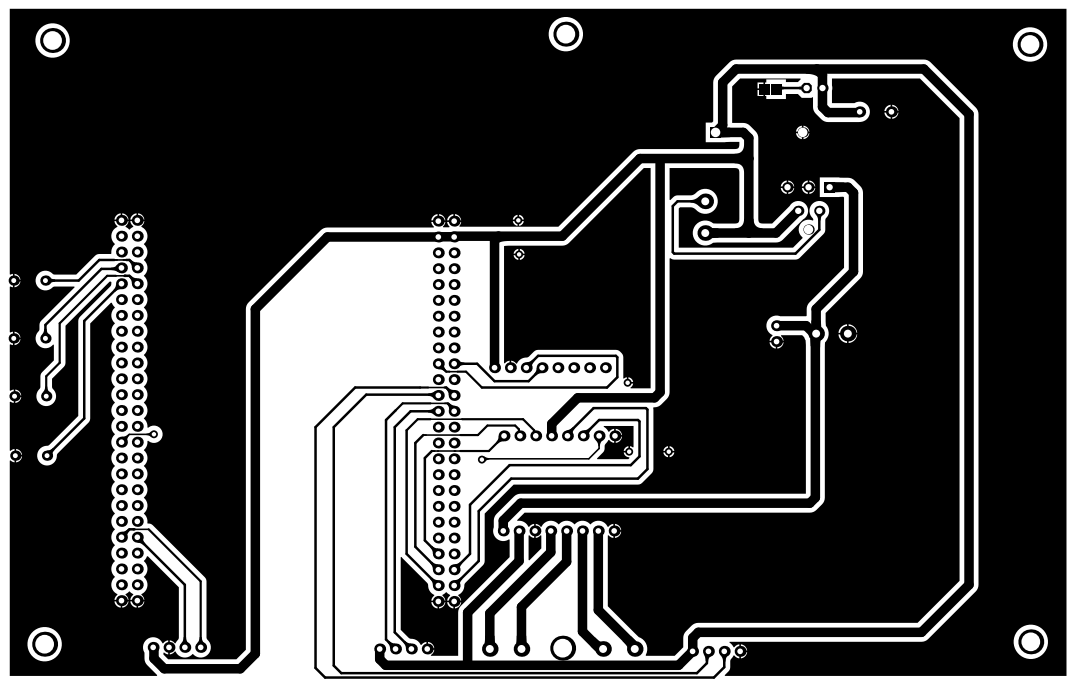
[picture p37: page 1]
