nguyentrongtri-05/balance-robot/(list of files, drawings)

Other design files:
Hardware/PCB_Project/PCB1.PcbDoc
Hardware/PCB_Project/PCB_Project.PrjPcb
Hardware/PCB_Project/Sheet1.SchDoc
