nguyentrongtri-05/balance-robot/.eide/eide.yml

version: "4.1"
name: template
type: ARM
deviceName: null
packDir: null
srcDirs: []
virtualFolder:
  name: <virtual_root>
  files: []
  folders:
    - name: USER
      files:
        - path: stm32f4xx_it.c
        - path: MDK_ARM/main.c
      folders: []
    - name: MDK ARM
      files:
        - path: system_stm32f4xx.c
      folders: []
    - name: CMSIS
      files:
        - path: Libraries/CMSIS/Device/ST/STM32F4xx/Source/Templates/arm/startup_stm32f40_41xxx.s
      folders: []
    - name: DRIVER
      files:
        - path: Libraries/STM32F4xx_StdPeriph_Driver/src/misc.c
        - path: Libraries/STM32F4xx_StdPeriph_Driver/src/stm32f4xx_adc.c
        - path: Libraries/STM32F4xx_StdPeriph_Driver/src/stm32f4xx_can.c
        - path: Libraries/STM32F4xx_StdPeriph_Driver/src/stm32f4xx_dma.c
        - path: Libraries/STM32F4xx_StdPeriph_Driver/src/stm32f4xx_flash.c
        - path: Libraries/STM32F4xx_StdPeriph_Driver/src/stm32f4xx_gpio.c
        - path: Libraries/STM32F4xx_StdPeriph_Driver/src/stm32f4xx_i2c.c
        - path: Libraries/STM32F4xx_StdPeriph_Driver/src/stm32f4xx_iwdg.c
        - path: Libraries/STM32F4xx_StdPeriph_Driver/src/stm32f4xx_rcc.c
        - path: Libraries/STM32F4xx_StdPeriph_Driver/src/stm32f4xx_spi.c
        - path: Libraries/STM32F4xx_StdPeriph_Driver/src/stm32f4xx_tim.c
        - path: Libraries/STM32F4xx_StdPeriph_Driver/src/stm32f4xx_syscfg.c
        - path: Libraries/STM32F4xx_StdPeriph_Driver/src/stm32f4xx_usart.c
        - path: Libraries/STM32F4xx_StdPeriph_Driver/src/stm32f4xx_wwdg.c
      folders: []
    - name: MY LIB
      files:
        - path: MY_LIB/encoder.c
        - path: MY_LIB/fuzzy.c
        - path: MY_LIB/gpio.c
        - path: MY_LIB/imu.c
        - path: MY_LIB/kalman.c
        - path: MY_LIB/managetask.c
        - path: MY_LIB/motor.c
        - path: MY_LIB/pid.c
        - path: MY_LIB/driver_flash.c
        - path: MY_LIB/driver_i2c.c
        - path: MY_LIB/driver_uart.c
      folders: []
    - name: FreeRTOS
      files:
        - path: FreeRTOS/list.c
        - path: FreeRTOS/queue.c
        - path: FreeRTOS/tasks.c
        - path: FreeRTOS/portable/MemMang/heap_4.c
        - path: FreeRTOS/portable/RVDS/ARM_CM4F/port.c
        - path: FreeRTOS/FreeRTOSConfig.h
      folders: []
dependenceList: []
outDir: build
miscInfo:
  uid: f833dc52bf7dd3f3471ec21c45478ac7
targets:
  Target 1:
    cppPreprocessAttrs:
      defineList:
        - STM32F40_41xxx
        - USE_STDPERIPH_DRIVER
        - HSE_VALUE=8000000
      incList:
        - ../Template_rtos
        - MDK_ARM
        - Libraries/CMSIS/Device/ST/STM32F4xx/Include
        - Libraries/STM32F4xx_StdPeriph_Driver/inc
        - Libraries/CMSIS/Include
        - FreeRTOS/include
        - FreeRTOS
        - FreeRTOS/portable/RVDS/ARM_CM4F
        - MY_LIB
        - .cmsis/include
        - MDK_ARM/RTE/_Target 1
      libList: []
    excludeList: []
    settings:
      debugger: cortex-debug
    toolchain: AC5
    toolchainConfigMap:
      AC5:
        archExtensions: ""
        cpuType: Cortex-M4
        floatingPointHardware: single
        options:
          version: 4
          afterBuildTasks: []
          asm-compiler:
            defines: []
          beforeBuildTasks: []
          c/cpp-compiler:
            CXX_FLAGS: --diag_suppress=1 --diag_suppress=1295
            C_FLAGS: --diag_suppress=1 --diag_suppress=1295
            c99-mode: true
            one-elf-section-per-function: true
            optimization: level-0
            warnings: all-warnings
          global:
            output-debug-info: enable
            use-microLIB: false
          linker:
            $outputTaskExcludes:
              - .bin
            output-format: elf
            ro-base: "0x08000000"
            rw-base: "0x20000000"
            xo-base: ""
        scatterFilePath: ""
        storageLayout:
          RAM:
            - id: 1
              isChecked: false
              mem:
                size: "0x0"
                startAddr: "0x0"
              noInit: false
              tag: RAM
            - id: 2
              isChecked: false
              mem:
                size: "0x0"
                startAddr: "0x0"
              noInit: false
              tag: RAM
            - id: 3
              isChecked: false
              mem:
                size: "0x0"
                startAddr: "0x0"
              noInit: false
              tag: RAM
            - id: 1
              isChecked: true
              mem:
                size: "0x20000"
                startAddr: "0x20000000"
              noInit: false
              tag: IRAM
            - id: 2
              isChecked: false
              mem:
                size: "0x10000"
                startAddr: "0x10000000"
              noInit: false
              tag: IRAM
          ROM:
            - id: 1
              isChecked: false
              isStartup: false
              mem:
                size: "0x0"
                startAddr: "0x0"
              tag: ROM
            - id: 2
              isChecked: false
              isStartup: false
              mem:
                size: "0x0"
                startAddr: "0x0"
              tag: ROM
            - id: 3
              isChecked: false
              isStartup: false
              mem:
                size: "0x0"
                startAddr: "0x0"
              tag: ROM
            - id: 1
              isChecked: true
              isStartup: true
              mem:
                size: "0x100000"
                startAddr: "0x8000000"
              tag: IROM
            - id: 2
              isChecked: false
              isStartup: false
              mem:
                size: "0x0"
                startAddr: "0x0"
              tag: IROM
        useCustomScatterFile: false
    uploadConfigMap:
      JLink:
        baseAddr: ""
        bin: ""
        cpuInfo:
          cpuName: "null"
          vendor: "null"
        otherCmds: ""
        proType: 1
        speed: 8000
      STLink:
        address: "0x8000000"
        bin: ""
        elFile: None
        optionBytes: .eide/target 1.st.option.bytes.ini
        otherCmds: ""
        proType: SWD
        resetMode: default
        runAfterProgram: true
        speed: 4000
    uploader: STLink
