nguyentrongtri-05/balance-robot/Firmware/MY_LIB/pid.c

#include "pid.h"

void PID_Init(PID_t *pid, float Kp, float Ki, float Kd, float outMin, float outMax) {
    pid->Kp = Kp;
    pid->Ki = Ki;
    pid->Kd = Kd;
		
		pid->P_part=0;
		pid->I_Part=0;
		pid->D_part=0;
    
		pid->Output=0;
    pid->pre_Error = 0.0f;
    pid->pre_pre_Error = 0.0f;
    pid->pre_Output = 0.0f;
    
    pid->outMin = outMin;
    pid->outMax = outMax;
}

void PID_Reset(PID_t *pid) {
    if (!pid) return;
    pid->P_part        = 0.0f;
    pid->I_Part        = 0.0f;
    pid->D_part        = 0.0f;
    pid->Output        = 0.0f;
    pid->pre_Error     = 0.0f;
    pid->pre_pre_Error = 0.0f;
    pid->pre_Output    = 0.0f;
}

float PID_Compute(PID_t *pid, float setpoint, float measurement, float dt) {
    float Error = setpoint - measurement;
    
    /* Tính toán các khâu gia số (Delta u) */
    
    /* 1. Khâu Tỷ lệ (P): 
     * Kp * (e(k) - e(k-1)) */
    pid->P_part = pid->Kp * (Error - pid->pre_Error);
    
    /* 2. Khâu Tích phân (I): Dùng phương pháp hình thang (Trapezoidal)
     * 0.5 * Ki * T * (e(k) + e(k-1)) */
    pid->I_Part = 0.5f * pid->Ki * dt * (Error + pid->pre_Error);
    
    /* 3. Khâu Vi phân (D):
     * (Kd / T) * (e(k) - 2*e(k-1) + e(k-2)) */
    pid->D_part = (pid->Kd / dt) * (Error - 2.0f * pid->pre_Error + pid->pre_pre_Error);
    
    /* Cộng dồn lượng gia số vào Output cũ: u(k) = u(k-1) + delta_u */
    pid->Output = pid->pre_Output + pid->P_part + pid->I_Part + pid->D_part;
    
    /* Giới hạn ngõ ra (Clamping) */
    if (pid->Output > pid->outMax) {
        pid->Output = pid->outMax;
    } 
    else if (pid->Output < pid->outMin) {
        pid->Output = pid->outMin;
    }
    
    /* Cập nhật các biến trạng thái cho chu kỳ sau */
    pid->pre_pre_Error = pid->pre_Error;
    pid->pre_Error = Error;
    pid->pre_Output = pid->Output;
    
    return pid->Output;
}
