nguyentrongtri-05/balance-robot/MY_LIB/motor.h

#ifndef __MOTOR_H
#define __MOTOR_H

#include "stm32f4xx.h"

/* Cấu hình chu kỳ và Prescaler cho PWM TIM1 (Timer 1 chạy trên APB2 - 168MHz):
 *  - Tần số PWM = 168MHz / (2 * 8400) = 10.0 kHz
 *  - Độ phân giải phần cứng: 8400 mức (~13-bit, mịn 0.012% mỗi bước, tận dụng cả phần lẻ thập phân của float pwm) */
#define MOTOR_PWM_PERIOD        8400
#define MOTOR_PWM_PRESCALER     2

/* Tùy chọn đảo chiều nếu động cơ đấu dây ngược (0: Bình thường, 1: Đảo chiều) */
#define MOTOR_LEFT_INVERT       0
#define MOTOR_RIGHT_INVERT      1

/**
 * @brief Khởi tạo PWM TIM1 (PA8 - Bánh trái, PE11 - Bánh phải) 
 *        và GPIO điều khiển chiều (PC8, PC6 - Trái | PC9, PC7 - Phải)
 */
void Motor_Config(void);

/**
 * @brief Điều khiển riêng bánh trái (PA8: PWM, PC8 & PC6: Chiều)
 * @param pwm: Giá trị từ -8400.0f đến 8400.0f
 */
void Motor_SetPWM_Left(float pwm);

/**
 * @brief Điều khiển riêng bánh phải (PE11: PWM, PC9 & PC7: Chiều)
 * @param pwm: Giá trị từ -8400.0f đến 8400.0f
 */
void Motor_SetPWM_Right(float pwm);

/**
 * @brief Dừng cả 2 bánh xe (PWM = 0)
 */
void Motor_Stop(void);

#endif /* __MOTOR_H */
