nguyentrongtri-05/balance-robot/(commit log)

2026-09-06 Init project: Fuzzy-PID cascaded control for balancing robot on FreeRTOS
2026-09-07 Optimize control architecture: Correct cascade loop and add deadband compensation
    [managetask.c]
2026-09-07 update từ keilc sang vscode
2026-09-30 cap nhat driver encode, imu, pwm
2026-10-05 them chuc nhan button
2026-10-11 cap nhat he thong, da test het cac module -> ok
2026-10-11 gui goi tin picth no kalman va pitch have kalman de so sanh du lieu
2026-10-14 test các chức năng cân bằng, giữ hướng cho robot
2026-10-17 cap nhat bo loc kalman cho yaw, fusion encoder + yaw, chinh sua bdk fuzzy theo chuan
2026-10-20 hoan tat bo fuzzy PI odom + fuzzy PD pitch
2026-11-04 cap nhat vong dieu khien la 200hz
